fahimjahingir-arch/sacral-resection-guide/validation/autoclave_datasheet.csv

material | coupon | feature | nominal_mm | pre_mm | post_mm | cycles
PA12_SLS | 1 | slot_width | 1.4 |  |  | 1
PA12_SLS | 1 | hole1_dia | 1.8 |  |  | 1
PA12_SLS | 1 | hole2_dia | 1.8 |  |  | 1
PA12_SLS | 1 | hole3_dia | 1.8 |  |  | 1
PA12_SLS | 1 | block_length | 20.0 |  |  | 1
PA12_SLS | 1 | rib_length | 60.0 |  |  | 1
PA12_SLS | 1 | rib_bow | 0.0 |  |  | 1
PA12_SLS | 1 | slot_depth | 14.0 |  |  | 1
PA12_SLS | 2 | slot_width | 1.4 |  |  | 1
PA12_SLS | 2 | hole1_dia | 1.8 |  |  | 1
PA12_SLS | 2 | hole2_dia | 1.8 |  |  | 1
PA12_SLS | 2 | hole3_dia | 1.8 |  |  | 1
PA12_SLS | 2 | block_length | 20.0 |  |  | 1
PA12_SLS | 2 | rib_length | 60.0 |  |  | 1
PA12_SLS | 2 | rib_bow | 0.0 |  |  | 1
PA12_SLS | 2 | slot_depth | 14.0 |  |  | 1
PA12_SLS | 3 | slot_width | 1.4 |  |  | 1
PA12_SLS | 3 | hole1_dia | 1.8 |  |  | 1
PA12_SLS | 3 | hole2_dia | 1.8 |  |  | 1
PA12_SLS | 3 | hole3_dia | 1.8 |  |  | 1
PA12_SLS | 3 | block_length | 20.0 |  |  | 1
PA12_SLS | 3 | rib_length | 60.0 |  |  | 1
PA12_SLS | 3 | rib_bow | 0.0 |  |  | 1
PA12_SLS | 3 | slot_depth | 14.0 |  |  | 1
PA12_SLS | 4 | slot_width | 1.4 |  |  | 1
PA12_SLS | 4 | hole1_dia | 1.8 |  |  | 1
PA12_SLS | 4 | hole2_dia | 1.8 |  |  | 1
PA12_SLS | 4 | hole3_dia | 1.8 |  |  | 1
PA12_SLS | 4 | block_length | 20.0 |  |  | 1
PA12_SLS | 4 | rib_length | 60.0 |  |  | 1
PA12_SLS | 4 | rib_bow | 0.0 |  |  | 1
PA12_SLS | 4 | slot_depth | 14.0 |  |  | 1
PA12_SLS | 5 | slot_width | 1.4 |  |  | 1
PA12_SLS | 5 | hole1_dia | 1.8 |  |  | 1
PA12_SLS | 5 | hole2_dia | 1.8 |  |  | 1
PA12_SLS | 5 | hole3_dia | 1.8 |  |  | 1
PA12_SLS | 5 | block_length | 20.0 |  |  | 1
PA12_SLS | 5 | rib_length | 60.0 |  |  | 1
PA12_SLS | 5 | rib_bow | 0.0 |  |  | 1
PA12_SLS | 5 | slot_depth | 14.0 |  |  | 1
SLA_bio_resin | 1 | slot_width | 1.4 |  |  | 1
SLA_bio_resin | 1 | hole1_dia | 1.8 |  |  | 1
SLA_bio_resin | 1 | hole2_dia | 1.8 |  |  | 1
SLA_bio_resin | 1 | hole3_dia | 1.8 |  |  | 1
SLA_bio_resin | 1 | block_length | 20.0 |  |  | 1
SLA_bio_resin | 1 | rib_length | 60.0 |  |  | 1
SLA_bio_resin | 1 | rib_bow | 0.0 |  |  | 1
SLA_bio_resin | 1 | slot_depth | 14.0 |  |  | 1
SLA_bio_resin | 2 | slot_width | 1.4 |  |  | 1
SLA_bio_resin | 2 | hole1_dia | 1.8 |  |  | 1
SLA_bio_resin | 2 | hole2_dia | 1.8 |  |  | 1
SLA_bio_resin | 2 | hole3_dia | 1.8 |  |  | 1
SLA_bio_resin | 2 | block_length | 20.0 |  |  | 1
SLA_bio_resin | 2 | rib_length | 60.0 |  |  | 1
SLA_bio_resin | 2 | rib_bow | 0.0 |  |  | 1
SLA_bio_resin | 2 | slot_depth | 14.0 |  |  | 1
SLA_bio_resin | 3 | slot_width | 1.4 |  |  | 1
SLA_bio_resin | 3 | hole1_dia | 1.8 |  |  | 1
SLA_bio_resin | 3 | hole2_dia | 1.8 |  |  | 1
SLA_bio_resin | 3 | hole3_dia | 1.8 |  |  | 1
SLA_bio_resin | 3 | block_length | 20.0 |  |  | 1
SLA_bio_resin | 3 | rib_length | 60.0 |  |  | 1
SLA_bio_resin | 3 | rib_bow | 0.0 |  |  | 1
SLA_bio_resin | 3 | slot_depth | 14.0 |  |  | 1
SLA_bio_resin | 4 | slot_width | 1.4 |  |  | 1
SLA_bio_resin | 4 | hole1_dia | 1.8 |  |  | 1
SLA_bio_resin | 4 | hole2_dia | 1.8 |  |  | 1
SLA_bio_resin | 4 | hole3_dia | 1.8 |  |  | 1
SLA_bio_resin | 4 | block_length | 20.0 |  |  | 1
SLA_bio_resin | 4 | rib_length | 60.0 |  |  | 1
SLA_bio_resin | 4 | rib_bow | 0.0 |  |  | 1
SLA_bio_resin | 4 | slot_depth | 14.0 |  |  | 1
SLA_bio_resin | 5 | slot_width | 1.4 |  |  | 1
SLA_bio_resin | 5 | hole1_dia | 1.8 |  |  | 1
SLA_bio_resin | 5 | hole2_dia | 1.8 |  |  | 1
SLA_bio_resin | 5 | hole3_dia | 1.8 |  |  | 1
SLA_bio_resin | 5 | block_length | 20.0 |  |  | 1
SLA_bio_resin | 5 | rib_length | 60.0 |  |  | 1
SLA_bio_resin | 5 | rib_bow | 0.0 |  |  | 1
SLA_bio_resin | 5 | slot_depth | 14.0 |  |  | 1
