fahimjahingir-arch/sacral-resection-guide/outputs/test_fixture.stl

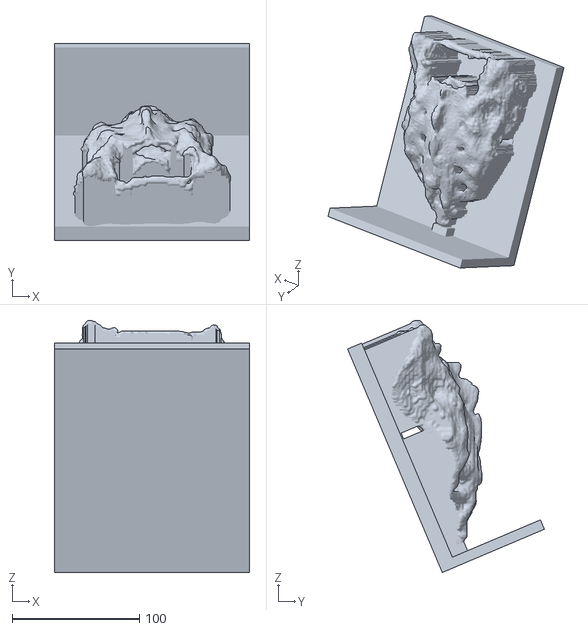
[picture p19: CAD file, 2026-11-11]
outputs/test_fixture.stl
153.5 x 154.8 x 198.2
