fahimjahingir-arch/sacral-resection-guide/outputs/autoclave_coupon.stl

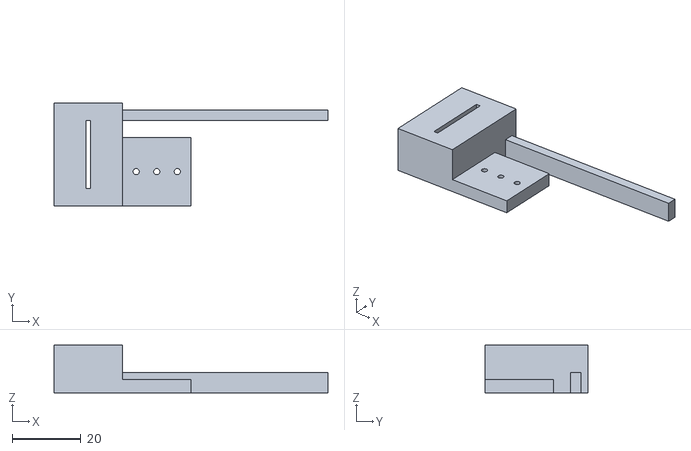
[picture p20: CAD file, 2026-11-11]
outputs/autoclave_coupon.stl
80.0 x 30.0 x 14.0
