fahimjahingir-arch/sacral-resection-guide/outputs/guide_B_wide.stl

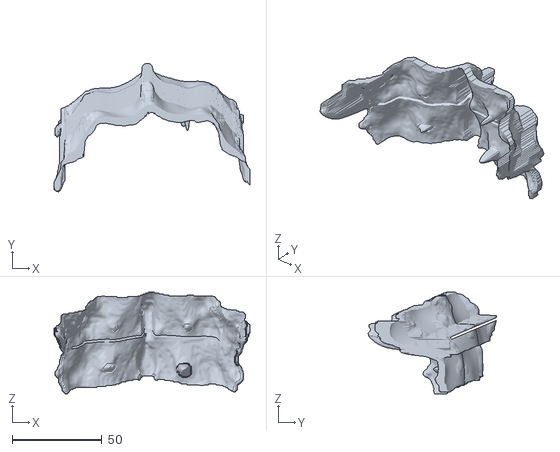
[picture p21: CAD file, 2026-11-11]
outputs/guide_B_wide.stl
109.0 x 71.7 x 56.5
