fahimjahingir-arch/sacral-resection-guide/outputs/guide_A_narrow.stl

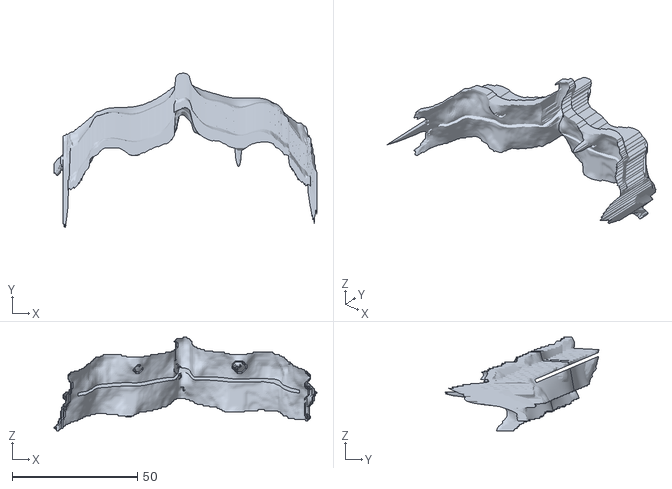
[picture p22: CAD file, 2026-11-11]
outputs/guide_A_narrow.stl
105.0 x 61.7 x 37.5
