fahimjahingir-arch/sacral-resection-guide/outputs/guide_C_wide_kwires.stl

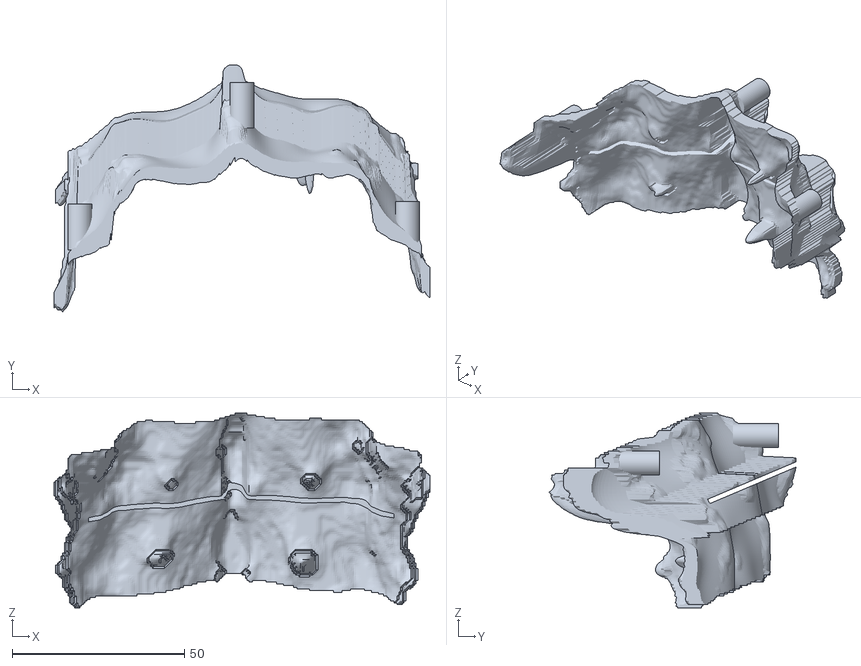
[picture p23: CAD file, 2026-11-11]
outputs/guide_C_wide_kwires.stl
109.0 x 71.7 x 56.5
