fahimjahingir-arch/sacral-resection-guide/outputs/bone.stl

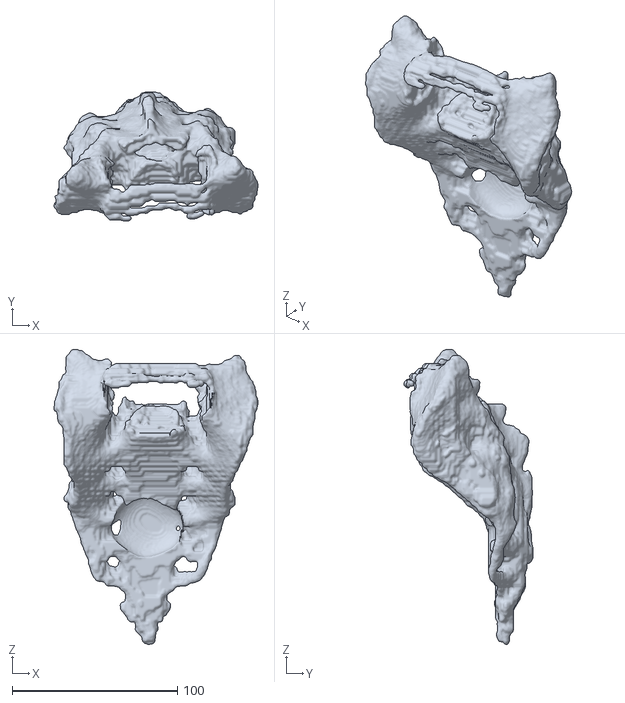
[picture p24: CAD file, 2026-11-11]
outputs/bone.stl
123.5 x 78.4 x 178.7
