fahimjahingir-arch/sacral-resection-guide/outputs/tumor.stl

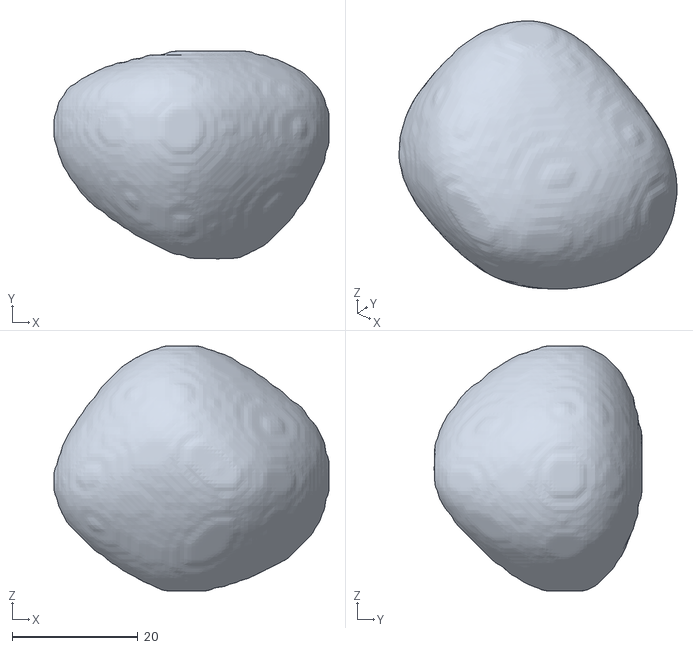
[picture p25: CAD file, 2026-11-11]
outputs/tumor.stl
43.8 x 33.1 x 39.0
