fahimjahingir-arch/sacral-resection-guide/outputs/figures/04_guide_A_narrow.png

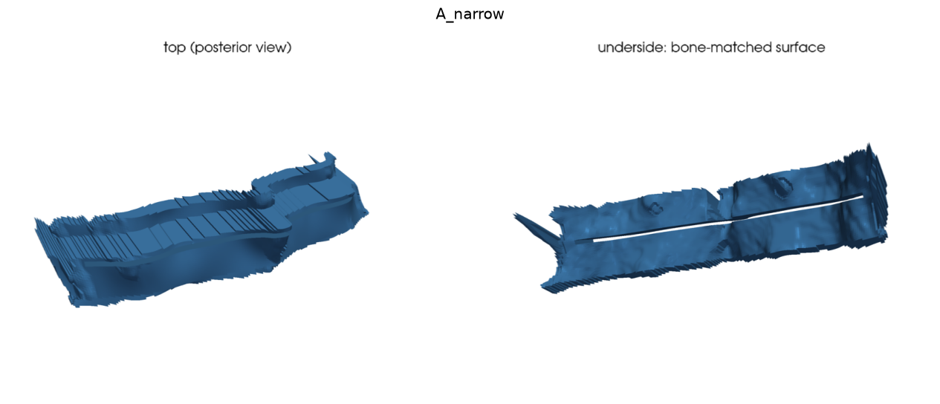
outputs/figures/04_guide_A_narrow.png
