fahimjahingir-arch/sacral-resection-guide/outputs_phantom/figures/04_guide_A_narrow.png

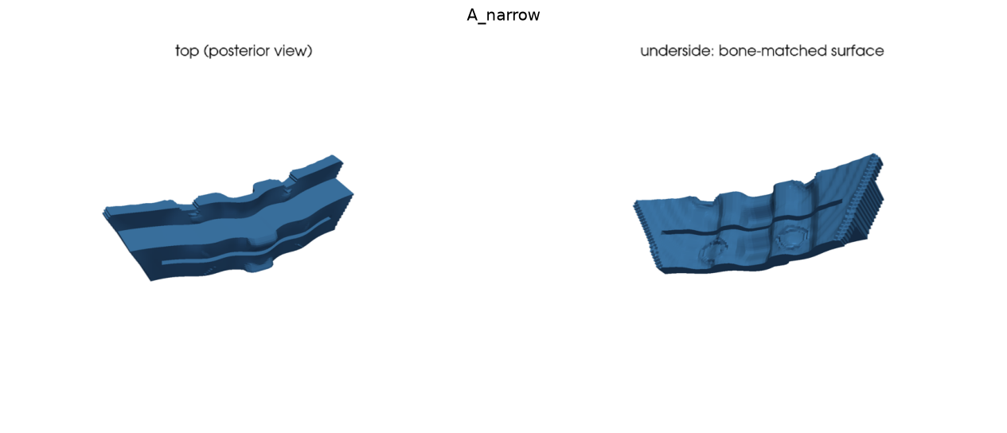
outputs_phantom/figures/04_guide_A_narrow.png
