fahimjahingir-arch/sacral-resection-guide/validation/repeatability_datasheet.csv

variant | operator | trial | offset_mm | angle_deg | notes
A_narrow | op1 | 1
A_narrow | op1 | 2
A_narrow | op1 | 3
A_narrow | op1 | 4
A_narrow | op1 | 5
A_narrow | op1 | 6
A_narrow | op1 | 7
A_narrow | op1 | 8
A_narrow | op1 | 9
A_narrow | op1 | 10
A_narrow | op2 | 1
A_narrow | op2 | 2
A_narrow | op2 | 3
A_narrow | op2 | 4
A_narrow | op2 | 5
A_narrow | op2 | 6
A_narrow | op2 | 7
A_narrow | op2 | 8
A_narrow | op2 | 9
A_narrow | op2 | 10
A_narrow | op3 | 1
A_narrow | op3 | 2
A_narrow | op3 | 3
A_narrow | op3 | 4
A_narrow | op3 | 5
A_narrow | op3 | 6
A_narrow | op3 | 7
A_narrow | op3 | 8
A_narrow | op3 | 9
A_narrow | op3 | 10
A_narrow | op4 | 1
A_narrow | op4 | 2
A_narrow | op4 | 3
A_narrow | op4 | 4
A_narrow | op4 | 5
A_narrow | op4 | 6
A_narrow | op4 | 7
A_narrow | op4 | 8
A_narrow | op4 | 9
A_narrow | op4 | 10
A_narrow | op5 | 1
A_narrow | op5 | 2
A_narrow | op5 | 3
A_narrow | op5 | 4
A_narrow | op5 | 5
A_narrow | op5 | 6
A_narrow | op5 | 7
A_narrow | op5 | 8
A_narrow | op5 | 9
A_narrow | op5 | 10
B_wide | op1 | 1
B_wide | op1 | 2
B_wide | op1 | 3
B_wide | op1 | 4
B_wide | op1 | 5
B_wide | op1 | 6
B_wide | op1 | 7
B_wide | op1 | 8
B_wide | op1 | 9
B_wide | op1 | 10
B_wide | op2 | 1
B_wide | op2 | 2
B_wide | op2 | 3
B_wide | op2 | 4
B_wide | op2 | 5
B_wide | op2 | 6
B_wide | op2 | 7
B_wide | op2 | 8
B_wide | op2 | 9
B_wide | op2 | 10
B_wide | op3 | 1
B_wide | op3 | 2
B_wide | op3 | 3
B_wide | op3 | 4
B_wide | op3 | 5
B_wide | op3 | 6
B_wide | op3 | 7
B_wide | op3 | 8
B_wide | op3 | 9
B_wide | op3 | 10
B_wide | op4 | 1
B_wide | op4 | 2
B_wide | op4 | 3
B_wide | op4 | 4
B_wide | op4 | 5
B_wide | op4 | 6
B_wide | op4 | 7
B_wide | op4 | 8
B_wide | op4 | 9
B_wide | op4 | 10
B_wide | op5 | 1
B_wide | op5 | 2
B_wide | op5 | 3
B_wide | op5 | 4
B_wide | op5 | 5
B_wide | op5 | 6
B_wide | op5 | 7
B_wide | op5 | 8
B_wide | op5 | 9
B_wide | op5 | 10
C_wide_kwires | op1 | 1
C_wide_kwires | op1 | 2
C_wide_kwires | op1 | 3
C_wide_kwires | op1 | 4
C_wide_kwires | op1 | 5
C_wide_kwires | op1 | 6
C_wide_kwires | op1 | 7
C_wide_kwires | op1 | 8
C_wide_kwires | op1 | 9
C_wide_kwires | op1 | 10
C_wide_kwires | op2 | 1
C_wide_kwires | op2 | 2
C_wide_kwires | op2 | 3
C_wide_kwires | op2 | 4
C_wide_kwires | op2 | 5
C_wide_kwires | op2 | 6
C_wide_kwires | op2 | 7
C_wide_kwires | op2 | 8
C_wide_kwires | op2 | 9
C_wide_kwires | op2 | 10
C_wide_kwires | op3 | 1
C_wide_kwires | op3 | 2
C_wide_kwires | op3 | 3
C_wide_kwires | op3 | 4
C_wide_kwires | op3 | 5
C_wide_kwires | op3 | 6
C_wide_kwires | op3 | 7
C_wide_kwires | op3 | 8
C_wide_kwires | op3 | 9
C_wide_kwires | op3 | 10
C_wide_kwires | op4 | 1
C_wide_kwires | op4 | 2
C_wide_kwires | op4 | 3
C_wide_kwires | op4 | 4
C_wide_kwires | op4 | 5
C_wide_kwires | op4 | 6
C_wide_kwires | op4 | 7
C_wide_kwires | op4 | 8
C_wide_kwires | op4 | 9
C_wide_kwires | op4 | 10
C_wide_kwires | op5 | 1
C_wide_kwires | op5 | 2
C_wide_kwires | op5 | 3
C_wide_kwires | op5 | 4
C_wide_kwires | op5 | 5
C_wide_kwires | op5 | 6
C_wide_kwires | op5 | 7
C_wide_kwires | op5 | 8
C_wide_kwires | op5 | 9
C_wide_kwires | op5 | 10
