fahimjahingir-arch/sacral-resection-guide/(commit log)

2026-11-11 Patient-specific sacral resection guide pipeline
    CT -> sacrum segmentation (TotalSegmentator + sub-voxel refinement) ->
    osteotomy plan with 10 mm margin -> three surface-matched guide variants ->
    seating-stability simulation -> FEA -> printable STLs, bench-test kit and
    report. Includes a synthetic-phantom verification run and a real TCIA
    pelvic CT run with a simulated chordoma.
    [autoclave_coupon.stl, autoclave_datasheet.csv, bone.stl, guide_A_narrow.stl, guide_B_wide.stl, guide_C_wide_kwires.stl, repeatability_datasheet.csv, tumor.stl]
2026-11-11 Add test fixture STL and figure; cross-platform setup
    validation/fixture.py now also renders outputs/figures/09_fixture.png (fixes the broken image in REPORT.md). outputs/test_fixture.stl is committed instead of ignored, so the PROTOCOLS.md link resolves. README setup covers macOS/Linux and Windows.
    [test_fixture.stl]
